BareConductive/touch_board_cad_files/readme.md

Bare Conductive (http://www.bareconductive.com/)

# Bare Conductive Touch Board CAD files
These are the CAD files of the [Touch Board](http://www.bareconductive.com/shop/touch-board/).
