BareConductive/touch_board_cad_files/touch-board-ks-edition-schematic/readme.md

<a href="http://www.bareconductive.com/">Bare Conductive</a>

# Bare Conductive Touch Board Schematic Kickstarter Edition
This is the electrical schematic for the Kickstarter Edition of the [Touch Board](http://www.bareconductive.com/shop/touch-board/).

## Requirements
The Touch Board requires the following to function within the Arduino IDE. 

* [Arduino](http://arduino.cc/en/Main/Software) 1.0.5 or 1.5.6+ (1.5.6+ is strongly preferred).

* Arduino's instructions for installing libraries are available [here](http://arduino.cc/en/Guide/Libraries)

* [Bare Conductive MPR121 library](https://github.com/bareconductive/mpr121) (zip file download [here](https://github.com/bareconductive/mpr121/archive/public.zip))

* [Bare Conductive Arduino Hardware Plugins](https://github.com/bareconductive/bare-conductive-arduino) (zip file download [here](https://github.com/bareconductive/bare-conductive-arduino/archive/public.zip)) - instructions on installing this hardware plugin folder are available [here](https://github.com/bareconductive/bare-conductive-arduino).

## Open Source License

Reference designs are provided 'AS IS' and 'WITH ALL FAULTS. Bare Conductive Ltd. DISCLAIMS ALL OTHER WARRANTIES, EXPRESS OR IMPLIED,
REGARDING PRODUCTS, INCLUDING BUT NOT LIMITED TO, ANY IMPLIED WARRANTIES OF MERCHANTABILITY OR FITNESS FOR A 
PARTICULAR PURPOSE. Bare Conductive Ltd. may make changes to specifications and product descriptions at any time, without notice. The 
customer must not rely on the absence or characteristics of any features or instructions marked "reserved" or "undefined." Bare Conductive Ltd.
reserves these for future definition and shall have no responsibility whatsoever for conflicts or incompatibilities arising from future changes to 
them. The product information on the Web Site or Materials is subject to change without notice. Do not finalise a design with this information.
BARE CONDUCTIVE and TOUCH BOARD are a registered trademarks.
