BareConductive/touch_board_cad_files/eagle_files/touch_board.brd

## EAGLE design eagle_files/touch_board.brd (2014-10-09)

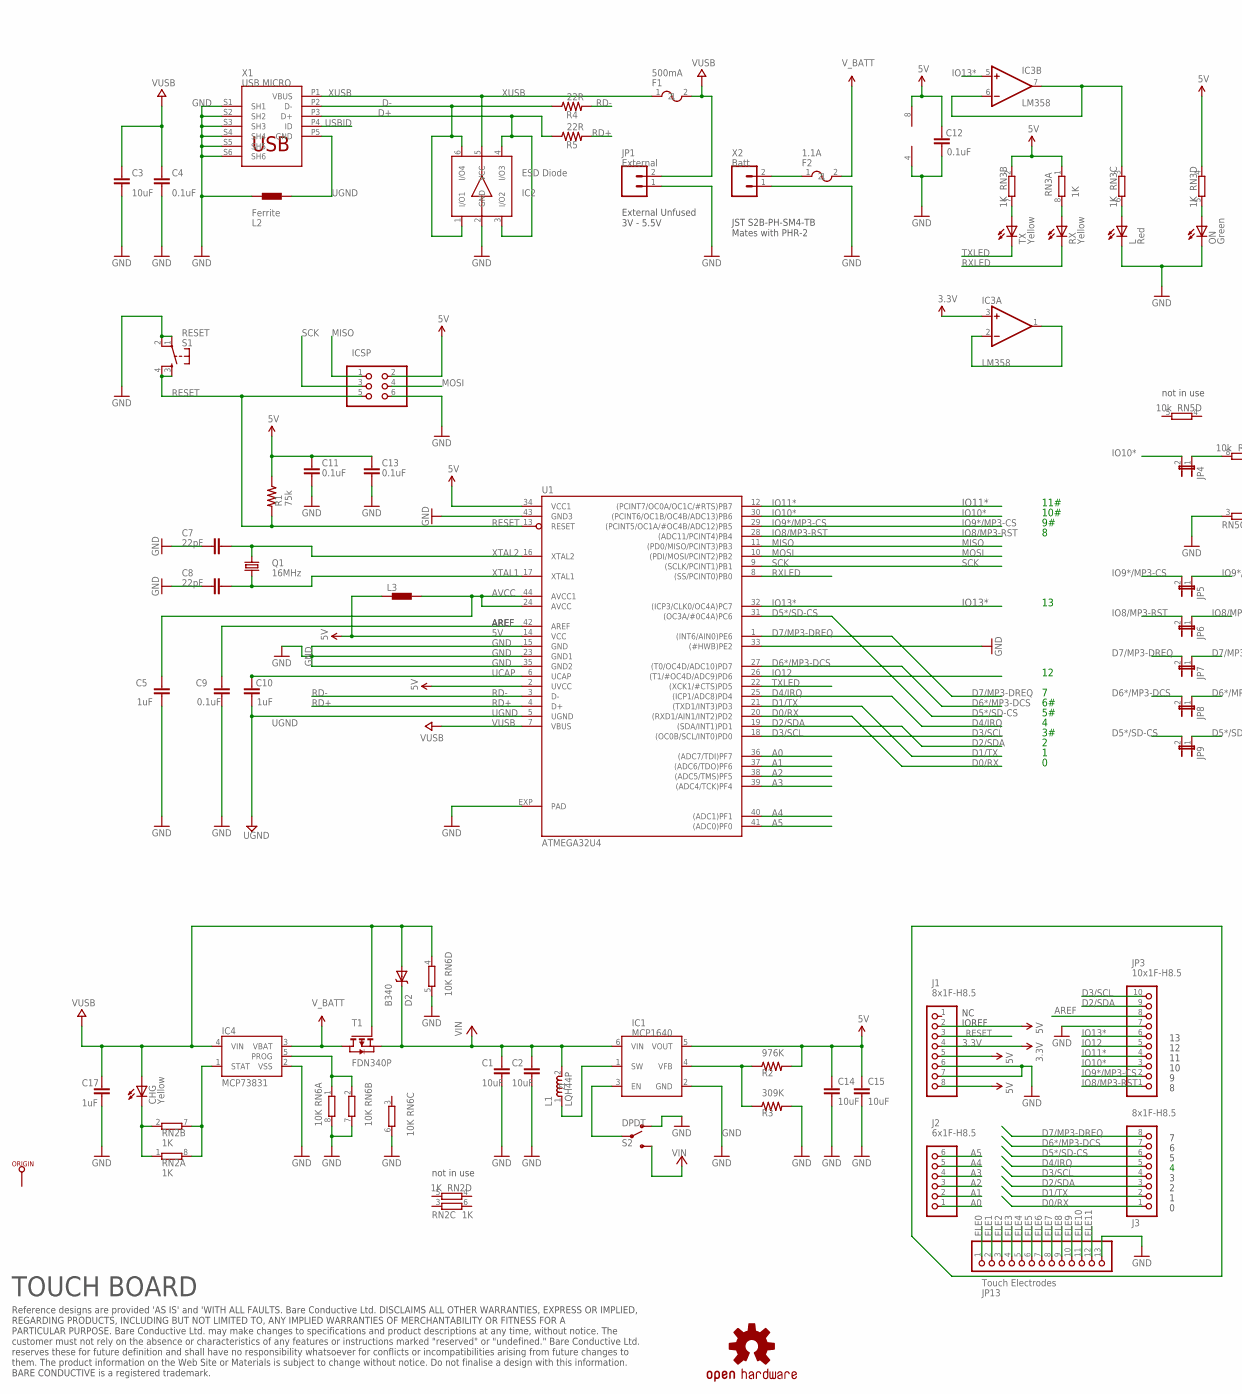
[picture p1: schematic touch_board.sch, part in row 1, column 1]

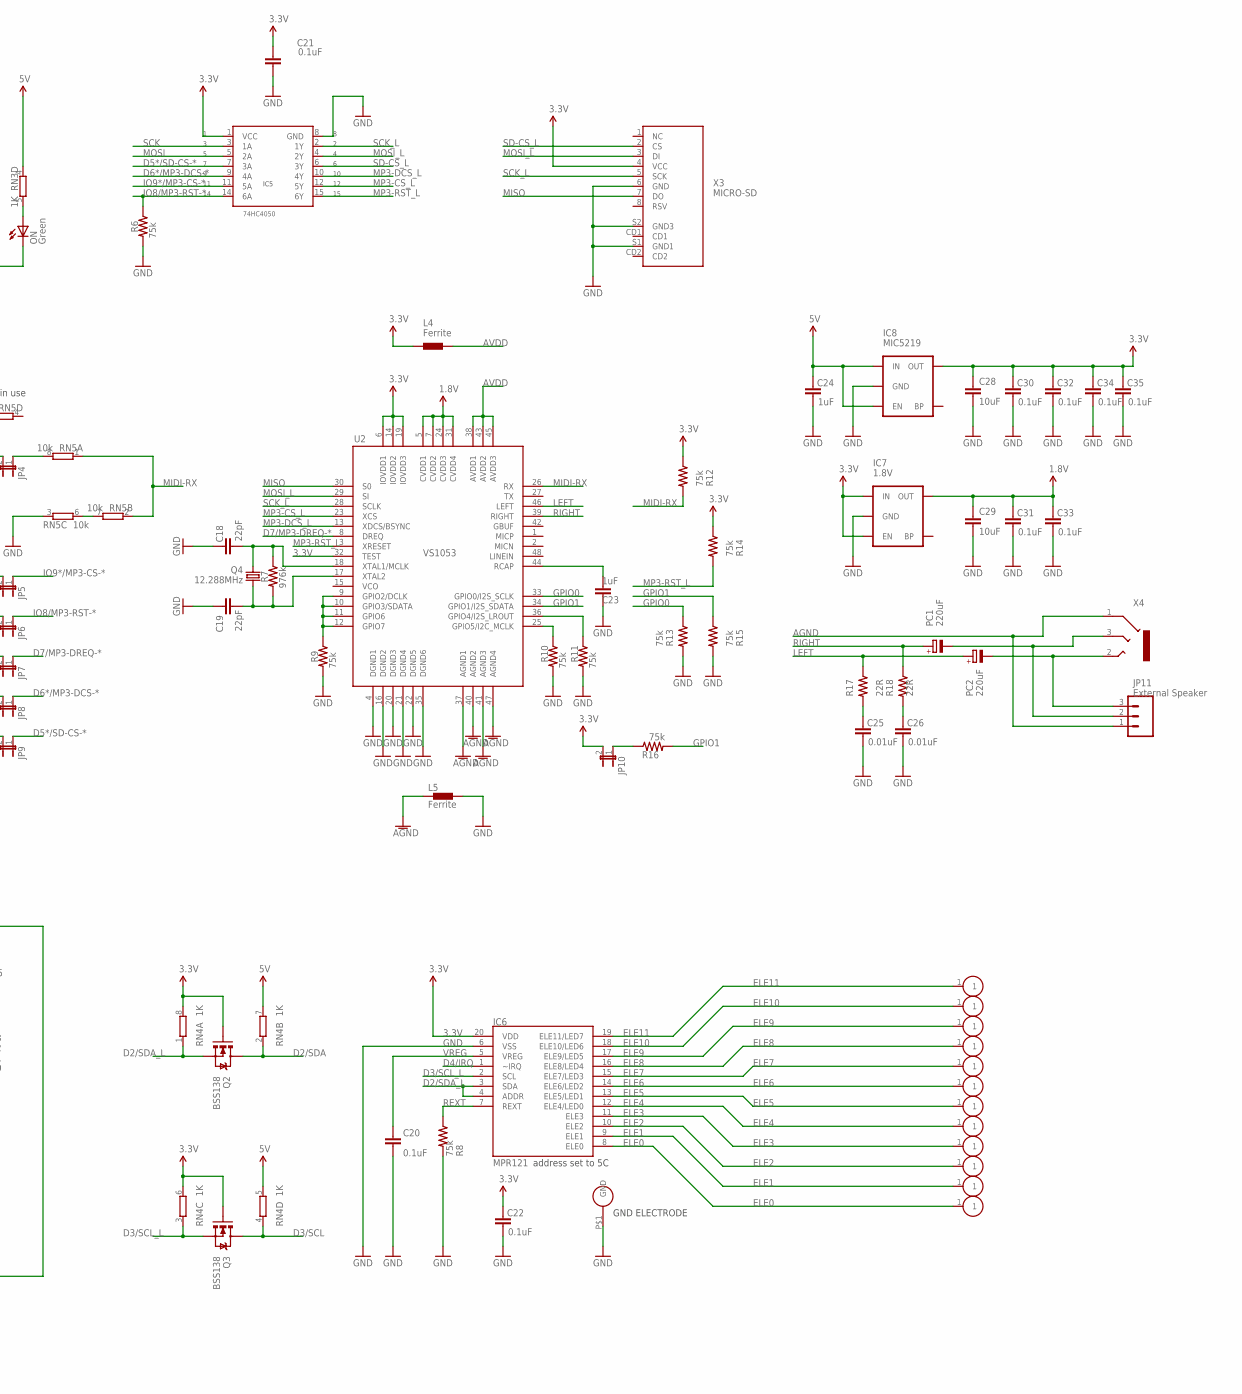
[picture p2: schematic touch_board.sch, part in row 1, column 2]

Parts:
C1, C2, C3, C14, C15, C28, C29: 10uF; 1206
C4, C9, C11, C12, C13, C20, C21, C22, C30, C31, C32, C33, C34, C35: 0.1uF; 0402-CAP
C5, C10, C17, C23, C24: 1uF; 0402-CAP
C7, C8, C18, C19: 22pF; 0402-CAP
C25, C26: 0.01uF; 0402-CAP
CHG: Yellow; CHIPLED_0805
D2: B340; SMA-DIODE
F1: 500mA; 0805
F2: 1.1A; 0805
IC1: MCP1640; 6-LEAD-SOT23
IC2: ESD Diode; SOT457
IC3: LM358; MSOP08
IC4: MCP73831; SOT23-5
IC5: 74HC4050; TSSOP-16
IC6: MPR121; QFN-20-0.4MM
IC7: 1.8V; SC70
IC8: MIC5219; SOT23-5
ICSP: ICSP; 2X03
J1, J3: 8x1F-H8.5; 1X08
J2: 6x1F-H8.5; 1X06
JP1: External; 1X02
JP3: 10x1F-H8.5; 1X10
JP4, JP10: JUMPER-2SMD-NO; SJ_2S-NO
JP5, JP6, JP7, JP8, JP9: JUMPER-2SMD-NC; SJ_2S
JP11: External Speaker; 1X03
JP13: Touch Electrodes; 1X13
L: Red; CHIPLED_0805
L1: LQH44P; LQH44PN100MP0L
L2, L4, L5: Ferrite; 0402
L3: BLM15HB121SN1; 0402
ON: Green; CHIPLED_0805
ORIGIN: TP_SP; TP-SP
PC1, PC2: 220uF; PANASONIC_D
Q1: 16MHz; CRYSTAL-SMD-5X3
Q2, Q3: BSS138; SOT23-3
Q4: 12.288MHz; CRYSTAL-SMD-5X3
R1, R6, R8, R9, R10, R11, R12, R13, R14, R15, R16: 75k; 0402-RES
R2: 976K; 0402-RES
R3: 309K; 0402-RES
R4, R5, R17, R18: 22R; 0402-RES
R7: 976k; 0402-RES
RN2, RN3, RN4: 1K; CAY16
RN5: 10k; CAY16
RN6: 10K; CAY16
RX: Yellow; CHIPLED_0805
S1: RESET; TACTILE_SWITCH_SMD@1
S2: DPDT; JS202011SCQN
T1: FDN340P; SOT-23
TX: Yellow; CHIPLED_0805
U1: ATMEGA32U4; QFN44ML7X7
U2: VS1053; LQFP-48
U$1: EDGE-ELEC-LEFT
U$3: EDGE-ELEC-RIGHT
U$6: EDGE-GND
U$8: OSHW-LOGO
U$17, U$18, U$22, U$24, U$26, U$27, U$28, U$29, U$30, U$31: EDGE-ELEC
X1: USB MICRO; CON2_USB_MICRO_B_AT
X2: Batt; JST-2-SMD
X3: MICRO-SD; MSDC-PP-02
X4: SJ-3523; 3POLE-JACK

Connections:
1.8V: C29.1, C31.2, C33.2, IC7.5 (OUT), U2.5 (CVDD1), U2.7 (CVDD2), U2.24 (CVDD3), U2.31 (CVDD4)
3.3V: C21.2, C22.2, C28.1, C30.2, C32.2, C34.2, C35.2, IC3.3 (+IN), IC5.1 (VCC), IC6.20 (VDD), IC7.1 (IN), IC7.3 (EN), IC8.5 (OUT), J1.4, JP10.2, L4.1, Q2.1 (G), Q3.1 (G), R12.1, R14.1, RN4.6 (2), RN4.8 (2), U2.6 (IOVDD1), U2.14 (IOVDD2), U2.19 (IOVDD3), U2.32 (TEST), X3.4 (VCC)
5V: C11.2, C12.2, C13.2, C14.1, C15.1, C24.2, IC1.5 (VOUT), IC3.8 (V+), IC8.1 (IN), IC8.3 (EN), ICSP.2, J1.2, J1.5, J1.8, L3.1, R1.1, R2.2, RN3.1, RN3.2 (1), RN3.4 (1), RN4.5 (2), RN4.7 (2), U1.2 (UVCC), U1.14 (VCC), U1.34 (VCC1)
A0: J2.1, U1.36 ((ADC7/TDI)PF7)
A1: J2.2, U1.37 ((ADC6/TDO)PF6)
A2: J2.3, U1.38 ((ADC5/TMS)PF5)
A3: J2.4, U1.39 ((ADC4/TCK)PF4)
A4: J2.5, U1.40 ((ADC1)PF1)
A5: J2.6, U1.41 ((ADC0)PF0)
AGND: JP11.1, L5.1, U2.37 (AGND1), U2.40 (AGND2), U2.41 (AGND3), U2.47 (AGND4), X4.1
AREF: C9.2, JP3.8, U1.42 (AREF)
AVCC: C5.2, L3.2, U1.24 (AVCC), U1.44 (AVCC1)
AVDD: L4.2, U2.38 (AVDD1), U2.43 (AVDD2), U2.45 (AVDD3)
D0/RX: J3.1, U1.20 ((RXD1/AIN1/INT2)PD2)
D1/TX: J3.2, U1.21 ((TXD1/INT3)PD3)
D2/SDA: J3.3, JP3.9, Q2.3 (D), RN4.2 (1), U1.19 ((SDA/INT1)PD1)
D2/SDA_L: IC6.3 (SDA), IC6.4 (ADDR), Q2.2 (S), RN4.1
D3/SCL: J3.4, JP3.10, Q3.3 (D), RN4.4 (1), U1.18 ((OC0B/SCL/INT0)PD0)
D3/SCL_L: IC6.2 (SCL), Q3.2 (S), RN4.3 (1)
D4/IRQ: IC6.1 (~IRQ), J3.5, U1.25 ((ICP1/ADC8)PD4)
D5*/SD-CS: J3.6, JP9.2, U1.31 ((OC3A/#0C4A)PC6)
D5*/SD-CS-*: IC5.7 (3A), JP9.1
D6*/MP3-DCS: J3.7, JP8.2, U1.27 ((T0/OC4D/ADC10)PD7)
D6*/MP3-DCS-*: IC5.9 (4A), JP8.1
D7/MP3-DREQ: J3.8, JP7.2, U1.1 ((INT6/AIN0)PE6)
D7/MP3-DREQ-*: JP7.1, U2.8 (DREQ)
D+: IC2.3 (I/O2), IC2.4 (I/O3), R5.1, X1.P3 (D+)
D-: IC2.1 (I/O1), IC2.6 (I/O4), R4.1, X1.P2 (D-)
ELE0: IC6.8 (ELE0), JP13.1, U$1.1
ELE1: IC6.9 (ELE1), JP13.2, U$31.1
ELE2: IC6.10 (ELE2), JP13.3, U$30.1
ELE3: IC6.11 (ELE3), JP13.4, U$29.1
ELE4: IC6.12 (ELE4/LED0), JP13.5, U$28.1
ELE5: IC6.13 (ELE5/LED1), JP13.6, U$27.1
ELE6: IC6.14 (ELE6/LED2), JP13.7, U$26.1
ELE7: IC6.15 (ELE7/LED3), JP13.8, U$24.1
ELE8: IC6.16 (ELE8/LED4), JP13.9, U$22.1
ELE9: IC6.17 (ELE9/LED5), JP13.10, U$18.1
ELE10: IC6.18 (ELE10/LED6), JP13.11, U$17.1
ELE11: IC6.19 (ELE11/LED7), JP13.12, U$3.1
G1: R9.1, U2.9 (GPIO2/DCLK), U2.10 (GPIO3/SDATA), U2.11 (GPIO6), U2.12 (GPIO7)
G2: R10.1, U2.25 (GPIO5/I2C_MCLK)
GND: C1.2, C2.2, C3.2, C4.1, C5.1, C7.2, C8.2, C9.1, C11.1, C12.1, C13.1, C14.2, C15.2, C17.1, C18.2, C19.2, C20.1, C21.1, C22.1, C23.2, C24.1, C25.1, C26.1, C28.2, C29.2, C30.1, C31.1, C32.1, C33.1, C34.1, C35.1, IC1.2 (GND), IC2.2 (GND), IC3.4 (V-), IC4.2 (VSS), IC5.8 (GND), IC6.6 (VSS), IC7.2 (GND), IC8.2 (GND), ICSP.6, J1.6, J1.7, JP1.1, JP3.7, JP13.13, L.C, L2.1, L5.2, ON.C, R3.2, R6.2, R8.2, R9.2, R10.2, R11.2, R13.2, R15.2, RN5.3 (1), RN6.5 (2), RN6.6 (2), RN6.7 (2), RN6.8 (2), S1.1, S1.2, S2.4, U1.15 (GND), U1.23 (GND1), U1.33 ((#HWB)PE2), U1.35 (GND2), U1.43 (GND3), U1.EXP (PAD), U2.4 (DGND1), U2.16 (DGND2), U2.20 (DGND3), U2.21 (DGND4), U2.22 (DGND5), U2.35 (DGND6), U$6.P$1, X1.S1 (SH1), X1.S2 (SH2), X1.S3 (SH3), X1.S4 (SH4), X1.S5 (SH5), X1.S6 (SH6), X2.1, X3.6 (GND), X3.S1 (GND1), X3.S2 (GND3)
GPIO0: R13.1, U2.33 (GPIO0/I2S_SCLK)
GPIO1: R15.1, R16.2, U2.34 (GPIO1/I2S_SDATA)
IO8/MP3-RST: JP3.1, JP6.2, U1.28 ((ADC11/PCINT4)PB4)
IO8/MP3-RST-*: IC5.14 (6A), JP6.1, R6.1
IO9*/MP3-CS: JP3.2, JP5.2, U1.29 ((PCINT5/OC1A/#OC4B/ADC12)PB5)
IO9*/MP3-CS-*: IC5.11 (5A), JP5.1
IO10*: JP3.3, JP4.2, U1.30 ((PCINT6/OC1B/OC4B/ADC13)PB6)
IO11*: JP3.4, U1.12 ((PCINT7/OC0A/OC1C/#RTS)PB7)
IO12: JP3.5, U1.26 ((T1/#OC4D/ADC9)PD6)
IO13*: IC3.5 (+IN), JP3.6, U1.32 ((ICP3/CLK0/OC4A)PC7)
LEFT: PC2.+, R17.1, U2.46 (LEFT)
MIDI-RX: R12.2, RN5.1, RN5.2 (1), U2.26 (RX)
MISO: ICSP.1, U1.11 ((PD0/MISO/PCINT3)PB3), U2.30 (S0), X3.7 (DO)
MOSI: IC5.5 (2A), ICSP.4, U1.10 ((PDI/MOSI/PCINT2)PB2)
MOSI_L: IC5.4 (2Y), U2.29 (SI), X3.3 (DI)
MP3-CS_L: IC5.12 (5Y), U2.23 (XCS)
MP3-DCS_L: IC5.10 (4Y), U2.13 (XDCS/BSYNC)
MP3-RST_L: IC5.15 (6Y), R14.2, U2.3 (XRESET)
unnamed: IC3.6 (-IN), IC3.7 (OUT), RN3.3 (1)
unnamed: L.A, RN3.6 (2)
unnamed: RN3.7 (2), TX.A
unnamed: IC4.1 (STAT), RN2.7 (2), RN2.8 (2)
unnamed: C23.1, U2.44 (RCAP)
unnamed: RN3.8 (2), RX.A
unnamed: ON.A, RN3.5 (2)
unnamed: C18.1, Q4.3 (2), R7.1, U2.18 (XTAL1/MCLK)
unnamed: C19.1, Q4.1, R7.2, U2.17 (XTAL2)
unnamed: IC1.1 (SW), L1.1
unnamed: IC1.4 (VFB), R2.1, R3.1
unnamed: F2.1, X2.2
unnamed: JP4.1, RN5.8 (2)
unnamed: IC3.1 (OUT), IC3.2 (-IN)
unnamed: IC4.5 (PROG), RN6.1, RN6.2 (1)
unnamed: C25.2, R17.2
unnamed: C26.2, R18.2
unnamed: IC1.3 (EN), S2.5
unnamed: JP11.3, PC2.-, X4.2
unnamed: JP10.1, R16.1
unnamed: JP11.2, PC1.-, X4.3
unnamed: RN5.6 (2), RN5.7 (2)
unnamed: CHG.C, RN2.1, RN2.2 (1)
unnamed: R11.1, U2.36 (GPIO4/I2S_LROUT)
RD+: R5.2, U1.4 (D+)
RD-: R4.2, U1.3 (D-)
RESET: ICSP.5, J1.3, R1.2, S1.3, S1.4, U1.13 (RESET)
REXT: IC6.7 (REXT), R8.1
RIGHT: PC1.+, R18.1, U2.39 (RIGHT)
RXLED: RX.C, U1.8 ((SS/PCINT0)PB0)
SCK: IC5.3 (1A), ICSP.3, U1.9 ((SCLK/PCINT1)PB1)
SCK_L: IC5.2 (1Y), U2.28 (SCLK), X3.5 (SCK)
SD-CS_L: IC5.6 (3Y), X3.2 (CS)
TXLED: TX.C, U1.22 ((XCK1/#CTS)PD5)
UCAP: C10.2, U1.6 (UCAP)
UGND: C10.1, L2.2, U1.5 (UGND), X1.P5 (GND)
USBID: X1.P4 (ID)
VCC: C1.1, C2.1, D2.C, IC1.6 (VIN), L1.2, S2.6, T1.2 (S)
VREG: C20.2, IC6.5 (VREG)
VUSB: C3.1, C4.2, C17.2, CHG.A, D2.A, F1.2, IC4.4 (VIN), JP1.2, RN6.4 (1), T1.3 (G), U1.7 (VBUS)
V_BATT: F2.2, IC4.3 (VBAT), T1.1 (D)
XTAL1: C8.1, Q1.1, U1.17 (XTAL1)
XTAL2: C7.1, Q1.3 (2), U1.16 (XTAL2)
XUSB: F1.1, IC2.5 (VCC), X1.P1 (VBUS)

Notes on the sheet:
USB
IOREF
10#
11#
Reference designs are provided 'AS IS' and 'WITH ALL FAULTS. Bare Conductive Ltd. DISCLAIMS ALL OTHER WARRANTIES, EXPRESS OR IMPLIED, REGARDING PRODUCTS, INCLUDING BUT NOT LIMITED TO, ANY IMPLIED WARRANTIES OF MERCHANTABILITY OR FITNESS FOR A PARTICULAR PURPOSE. Bare Conductive Ltd. may make change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
not in use
External Unfused 3V - 5.5V
address set to 5C
TOUCH BOARD
GND ELECTRODE
JST S2B-PH-SM4-TB Mates with PHR-2

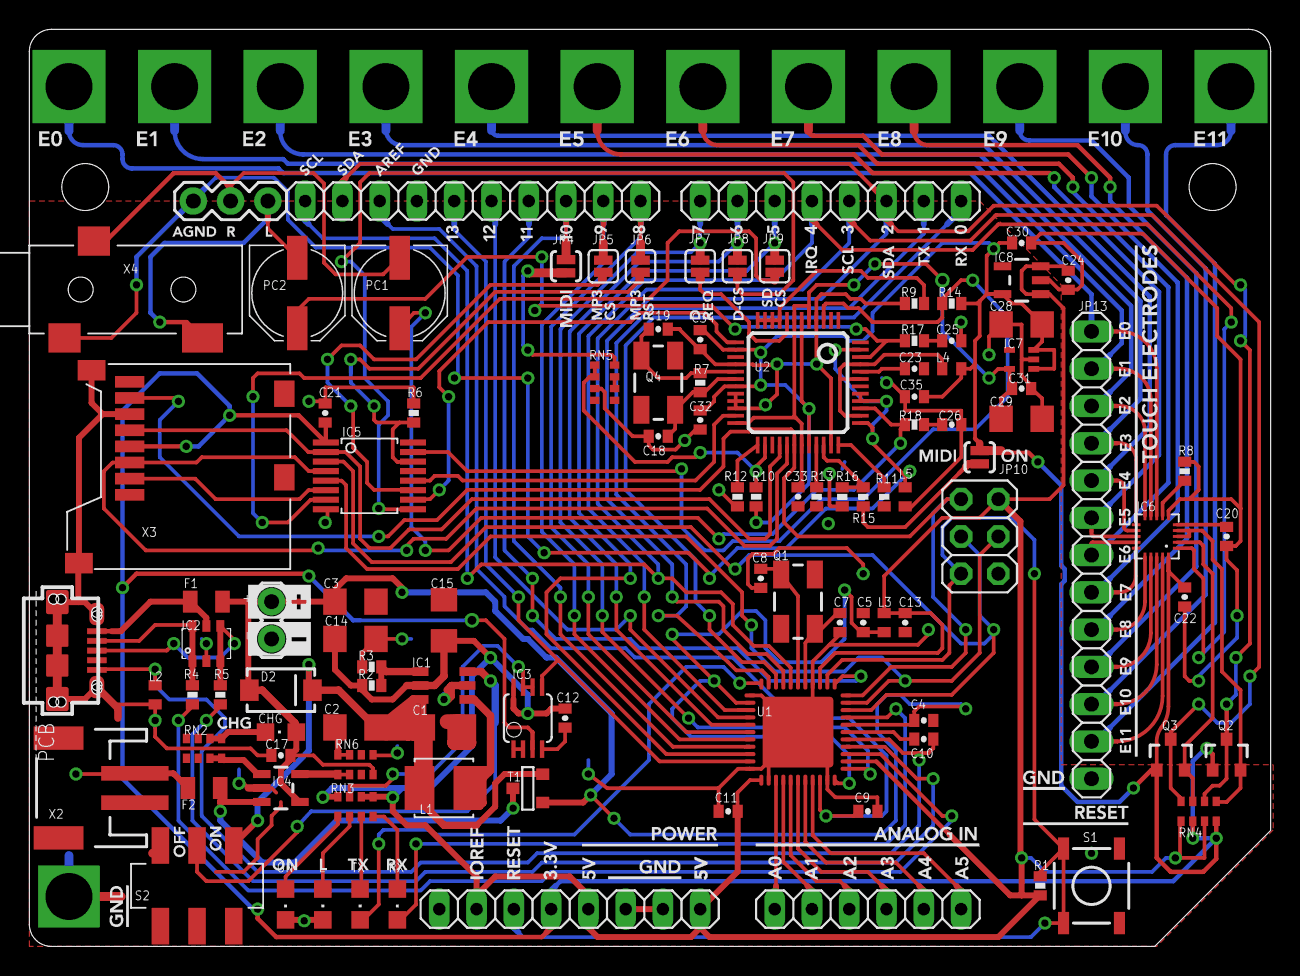
[picture p3: board touch_board.brd from above]

Board: 2 copper layers, 84.6 x 62.5 mm, 121 parts (0 on the bottom side), 104 nets.
