BareConductive/touch_board_cad_files/(commit log)

2014-10-06 Inital Commit with Schematic pdf
2014-10-09 Initial commit for eagel files
    [touch-board-ks-edition.brd, touch-board-ks-edition.sch]
2020-03-27 Renaming files and folders
    [touch_board.brd, touch_board.sch]
